DJilanov/diploma/SCH_PicoW_1-MAIN_2024-12-25.png

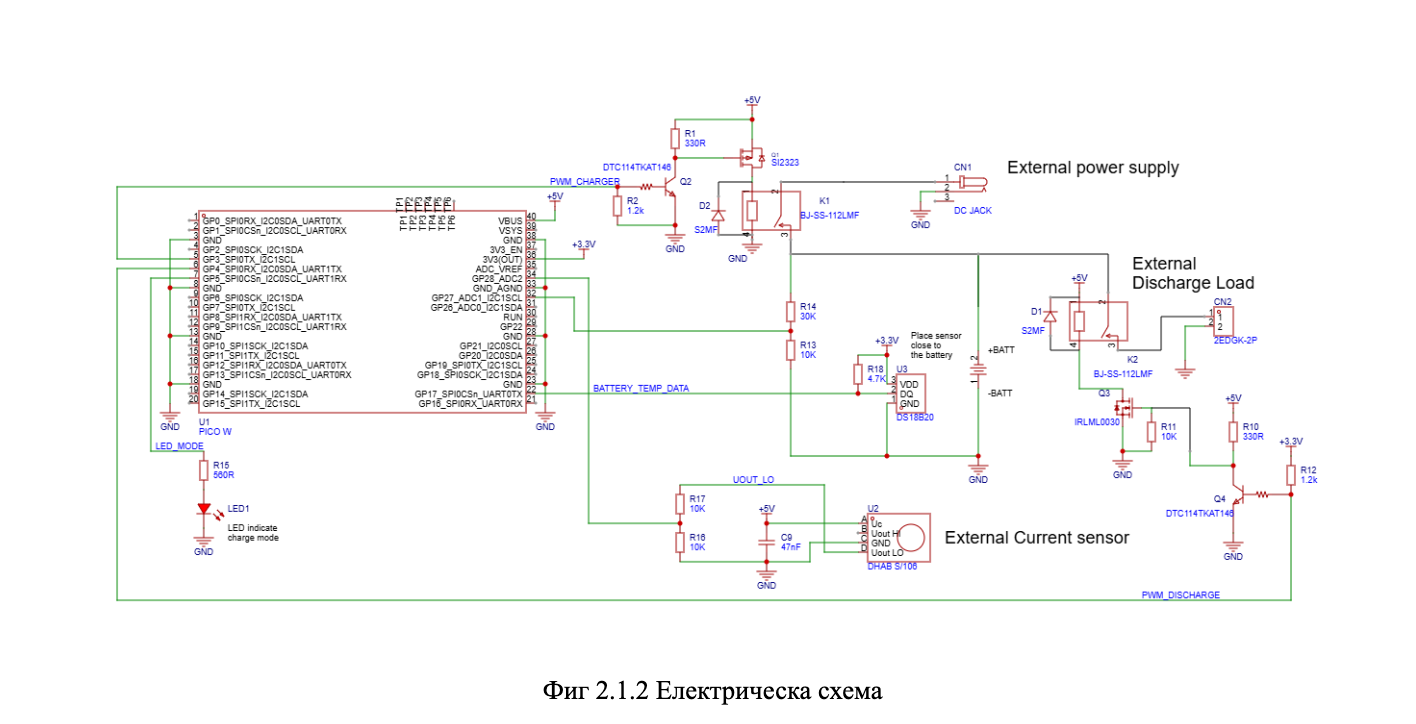
SCH_PicoW_1-MAIN_2024-12-25.png
