DJilanov/diploma/(list of files, drawings)

Other design files:
ProPrj_Pico_Pi_W_2024-12-25.epro
